Beirdo/obd-feather/README.md

# obd-feather
OBDII interface board with an attached Adafruit STM32F405 Feather Express.
