Beirdo/obd-feather/hardware/obd-feather/obd-feather.kicad_pcb

## KiCad design hardware/obd-feather/obd-feather.kicad_pcb (2023-03-13)

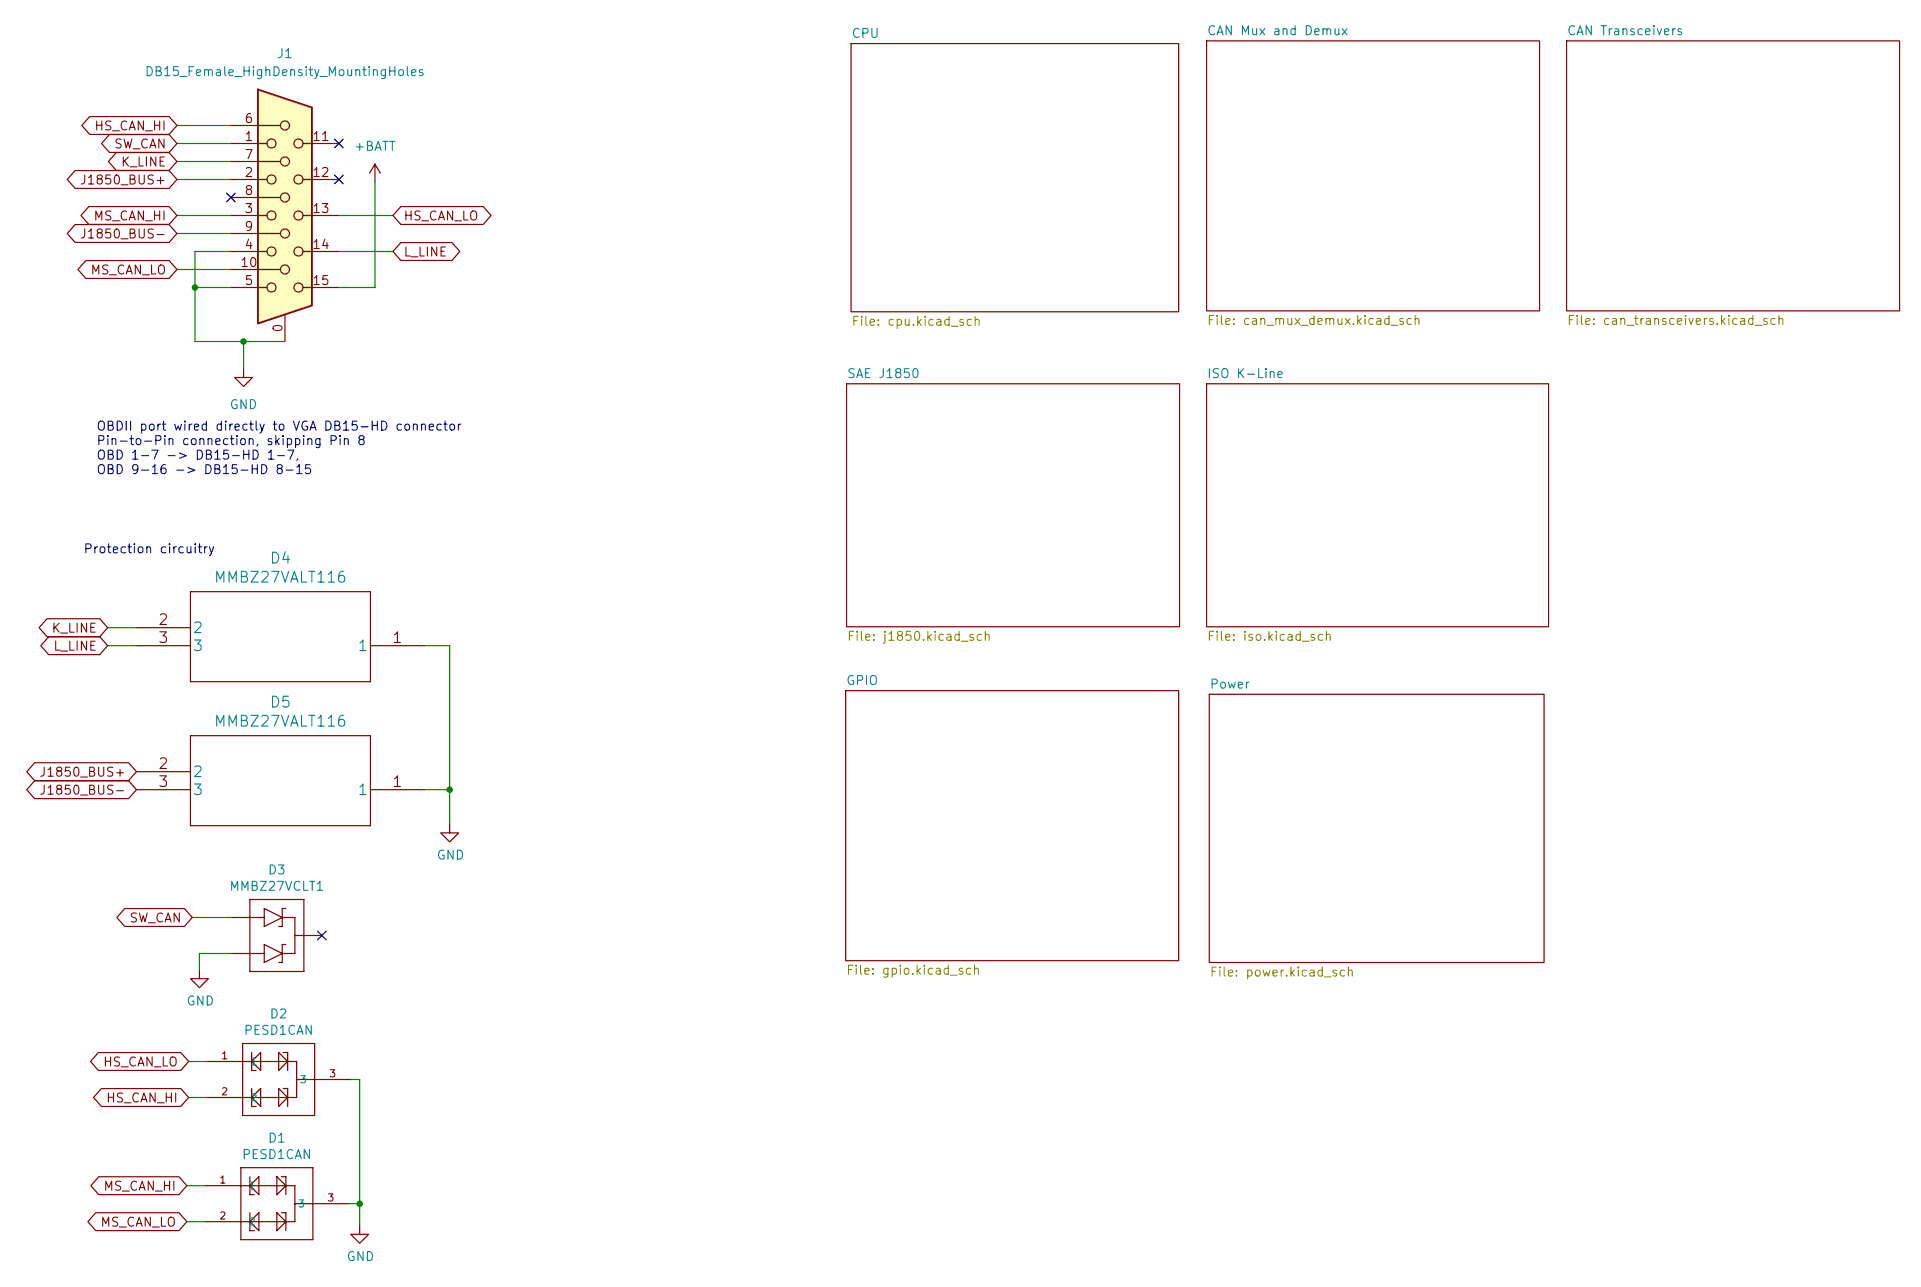
[picture p15: schematic obd-feather.kicad_sch, OBDII-Feather Interface]

Parts:
D1, D2: PESD1CAN; SOT23-3; Digikey 1727-3817-1-ND
D3: MMBZ27VCLT1; SOT23-3; Digikey MMBZ27VCL-FDICT-ND
D4, D5: MMBZ27VALT116; SOT23-3; Digikey MMBZ27VALT116CT-ND
J1: DB15_Female_HighDensity_MountingHoles; DSUB-15-HD_Female_Horizontal_P2.29x1.98mm_EdgePinOffset8.35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; Digikey L77HDE15SD1CH4FVGA-ND

Connections:
+BATT: J1.15; also elsewhere on the board
GND: D1.3, D2.3, D3.2 (A2), D4.1, D5.1, J1.0, J1.4, J1.5; also elsewhere on the board
HS_CAN_HI: D2.2, J1.6; also elsewhere on the board
HS_CAN_LO: D2.1, J1.13; also elsewhere on the board
J1850_BUS+: D5.2, J1.2; also elsewhere on the board
J1850_BUS-: D5.3, J1.9; also elsewhere on the board
K_LINE: D4.2, J1.7; also elsewhere on the board
L_LINE: D4.3, J1.14; also elsewhere on the board
MS_CAN_HI: D1.1, J1.3; also elsewhere on the board
MS_CAN_LO: D1.2, J1.10; also elsewhere on the board
SW_CAN: D3.1 (A1), J1.1; also elsewhere on the board

Notes on the sheet:
OBDII port wired directly to VGA DB15-HD connector Pin-to-Pin connection, skipping Pin 8 OBD 1-7 -> DB15-HD 1-7, OBD 9-16 -> DB15-HD 8-15
Protection circuitry

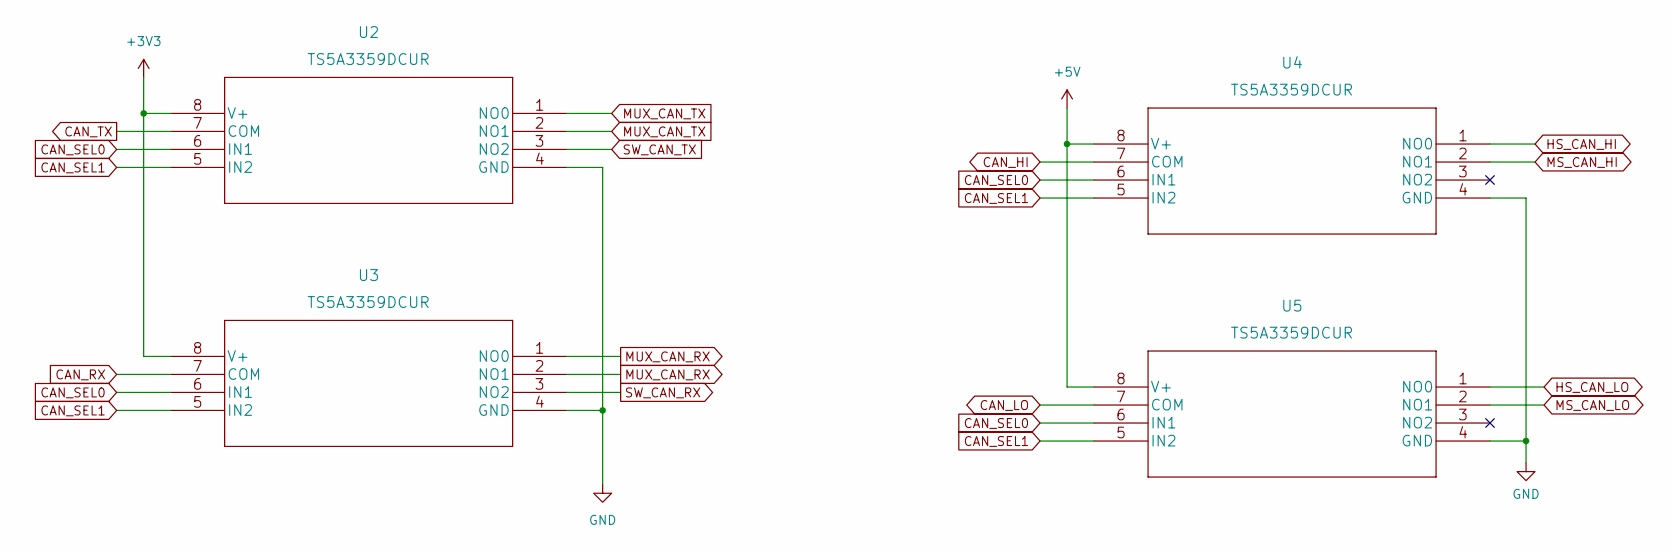
[picture p16: schematic can_mux_demux.kicad_sch, OBDII-Feather Interface]

Parts:
U2, U3, U4, U5: TS5A3359DCUR; Digikey 296-21193-1-ND

Connections:
+3V3: U2.8 (V+), U3.8 (V+); also elsewhere on the board
+5V: U4.8 (V+), U5.8 (V+); also elsewhere on the board
CAN_HI: U4.7 (COM); also elsewhere on the board
CAN_LO: U5.7 (COM); also elsewhere on the board
CAN_RX: U3.7 (COM); also elsewhere on the board
CAN_SEL0: U2.6 (IN1), U3.6 (IN1), U4.6 (IN1), U5.6 (IN1); also elsewhere on the board
CAN_SEL1: U2.5 (IN2), U3.5 (IN2), U4.5 (IN2), U5.5 (IN2); also elsewhere on the board
CAN_TX: U2.7 (COM); also elsewhere on the board
GND: U2.4 (GND), U3.4 (GND), U4.4 (GND), U5.4 (GND); also elsewhere on the board
HS_CAN_HI: U4.1 (NO0); also elsewhere on the board
HS_CAN_LO: U5.1 (NO0); also elsewhere on the board
MS_CAN_HI: U4.2 (NO1); also elsewhere on the board
MS_CAN_LO: U5.2 (NO1); also elsewhere on the board
MUX_CAN_RX: U3.1 (NO0), U3.2 (NO1); also elsewhere on the board
MUX_CAN_TX: U2.1 (NO0), U2.2 (NO1); also elsewhere on the board
SW_CAN_RX: U3.3 (NO2); also elsewhere on the board
SW_CAN_TX: U2.3 (NO2); also elsewhere on the board

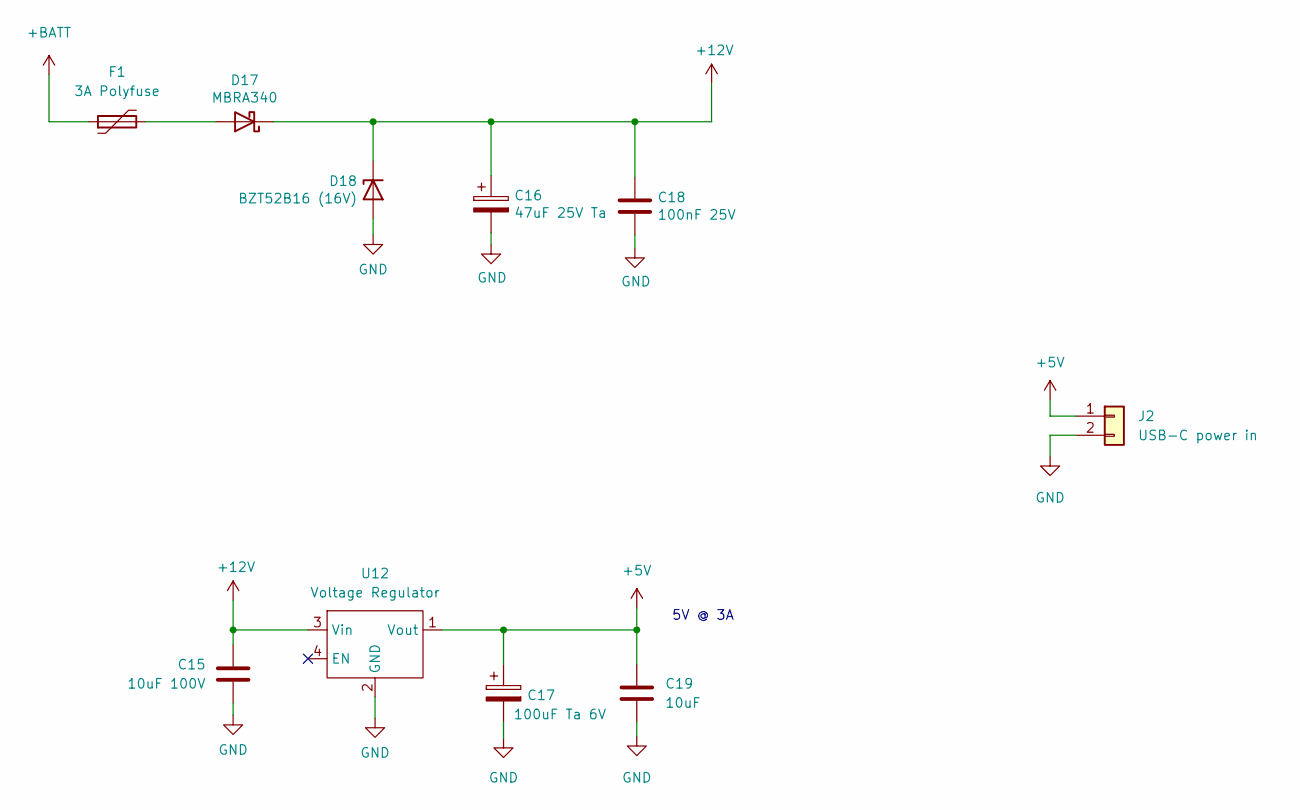
[picture p17: schematic power.kicad_sch, OBDII-Feather Interface]

Parts:
C15: 10uF 100V; C_1210_3225Metric_Pad1.33x2.70mm_HandSolder
C16: 47uF 25V Ta; CP_EIA-7343-31_Kemet-D_Pad2.25x2.55mm_HandSolder
C17: 100uF Ta 6V; CP_EIA-3216-10_Kemet-I_Pad1.58x1.35mm_HandSolder
C18: 100nF 25V; C_0805_2012Metric_Pad1.18x1.45mm_HandSolder
C19: 10uF; C_0805_2012Metric_Pad1.18x1.45mm_HandSolder
D17: MBRA340; D_SMA
D18: BZT52B16 (16V); D_SOD-123
F1: 3A Polyfuse; R_1812_4532Metric_Pad1.30x3.40mm_HandSolder; Digikey F2772CT-ND
J2: USB-C power in; PinHeader_1x02_P2.54mm_Vertical
U12: Voltage Regulator; Switching_Regulator_Module

Connections:
+5V: C17.1, C19.1, J2.1, U12.1 (Vout); also elsewhere on the board
+12V: C15.1, C16.1, C18.1, D17.1 (K), D18.1 (K), U12.3 (Vin); also elsewhere on the board
+BATT: F1.1; also elsewhere on the board
GND: C15.2, C16.2, C17.2, C18.2, C19.2, D18.2 (A), J2.2, U12.2 (GND); also elsewhere on the board
unnamed: D17.2 (A), F1.2

Notes on the sheet:
5V @ 3A

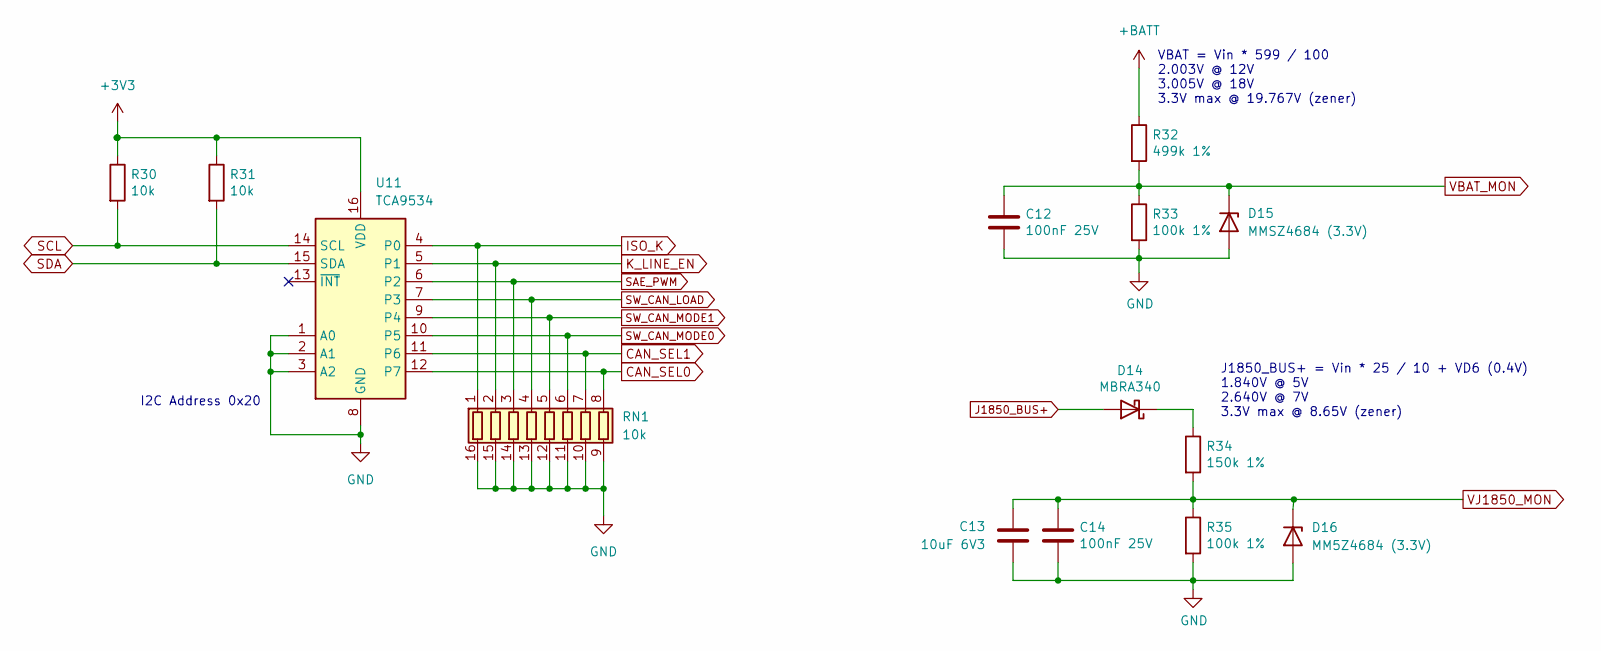
[picture p18: schematic gpio.kicad_sch, OBDII-Feather Interface]

Parts:
C12, C14: 100nF 25V; C_0805_2012Metric_Pad1.18x1.45mm_HandSolder
C13: 10uF 6V3; C_0805_2012Metric_Pad1.18x1.45mm_HandSolder
D14: MBRA340; D_SMA
D15: MMSZ4684 (3.3V); D_SOD-123
D16: MM5Z4684 (3.3V); D_SOD-123
R30, R31: 10k; R_0805_2012Metric_Pad1.20x1.40mm_HandSolder
R32: 499k 1%; R_0805_2012Metric_Pad1.20x1.40mm_HandSolder
R33, R35: 100k 1%; R_0805_2012Metric_Pad1.20x1.40mm_HandSolder
R34: 150k 1%; R_0805_2012Metric_Pad1.20x1.40mm_HandSolder
RN1: 10k; 742C163103JP
U11: TCA9534; TSSOP-16_4.4x5mm_P0.65mm

Connections:
+3V3: R30.1, R31.1, U11.16 (VDD); also elsewhere on the board
+BATT: R32.1; also elsewhere on the board
CAN_SEL0: RN1.8 (R8.1), U11.12 (P7); also elsewhere on the board
CAN_SEL1: RN1.7 (R7.1), U11.11 (P6); also elsewhere on the board
GND: C12.2, C13.1, C14.2, D15.2 (A), D16.2 (A), R33.2, R35.2, RN1.9 (R8.2), RN1.10 (R7.2), RN1.11 (R6.2), RN1.12 (R5.2), RN1.13 (R4.2), RN1.14 (R3.2), RN1.15 (R2.2), RN1.16 (R1.2), U11.1 (A0), U11.2 (A1), U11.3 (A2), U11.8 (GND); also elsewhere on the board
ISO_K: RN1.1 (R1.1), U11.4 (P0); also elsewhere on the board
J1850_BUS+: D14.2 (A); also elsewhere on the board
K_LINE_EN: RN1.2 (R2.1), U11.5 (P1); also elsewhere on the board
unnamed: D14.1 (K), R34.1
SAE_PWM: RN1.3 (R3.1), U11.6 (P2); also elsewhere on the board
SCL: R30.2, U11.14 (SCL); also elsewhere on the board
SDA: R31.2, U11.15 (SDA); also elsewhere on the board
SW_CAN_LOAD: RN1.4 (R4.1), U11.7 (P3); also elsewhere on the board
SW_CAN_MODE0: RN1.6 (R6.1), U11.10 (P5); also elsewhere on the board
SW_CAN_MODE1: RN1.5 (R5.1), U11.9 (P4); also elsewhere on the board
VBAT_MON: C12.1, D15.1 (K), R32.2, R33.1; also elsewhere on the board
VJ1850_MON: C13.2, C14.1, D16.1 (K), R34.2, R35.1; also elsewhere on the board

Notes on the sheet:
J1850_BUS+ = Vin * 25 / 10 + VD6 (0.4V) 1.840V @ 5V 2.640V @ 7V 3.3V max @ 8.65V (zener)
I2C Address 0x20
VBAT = Vin * 599 / 100 2.003V @ 12V 3.005V @ 18V 3.3V max @ 19.767V (zener)

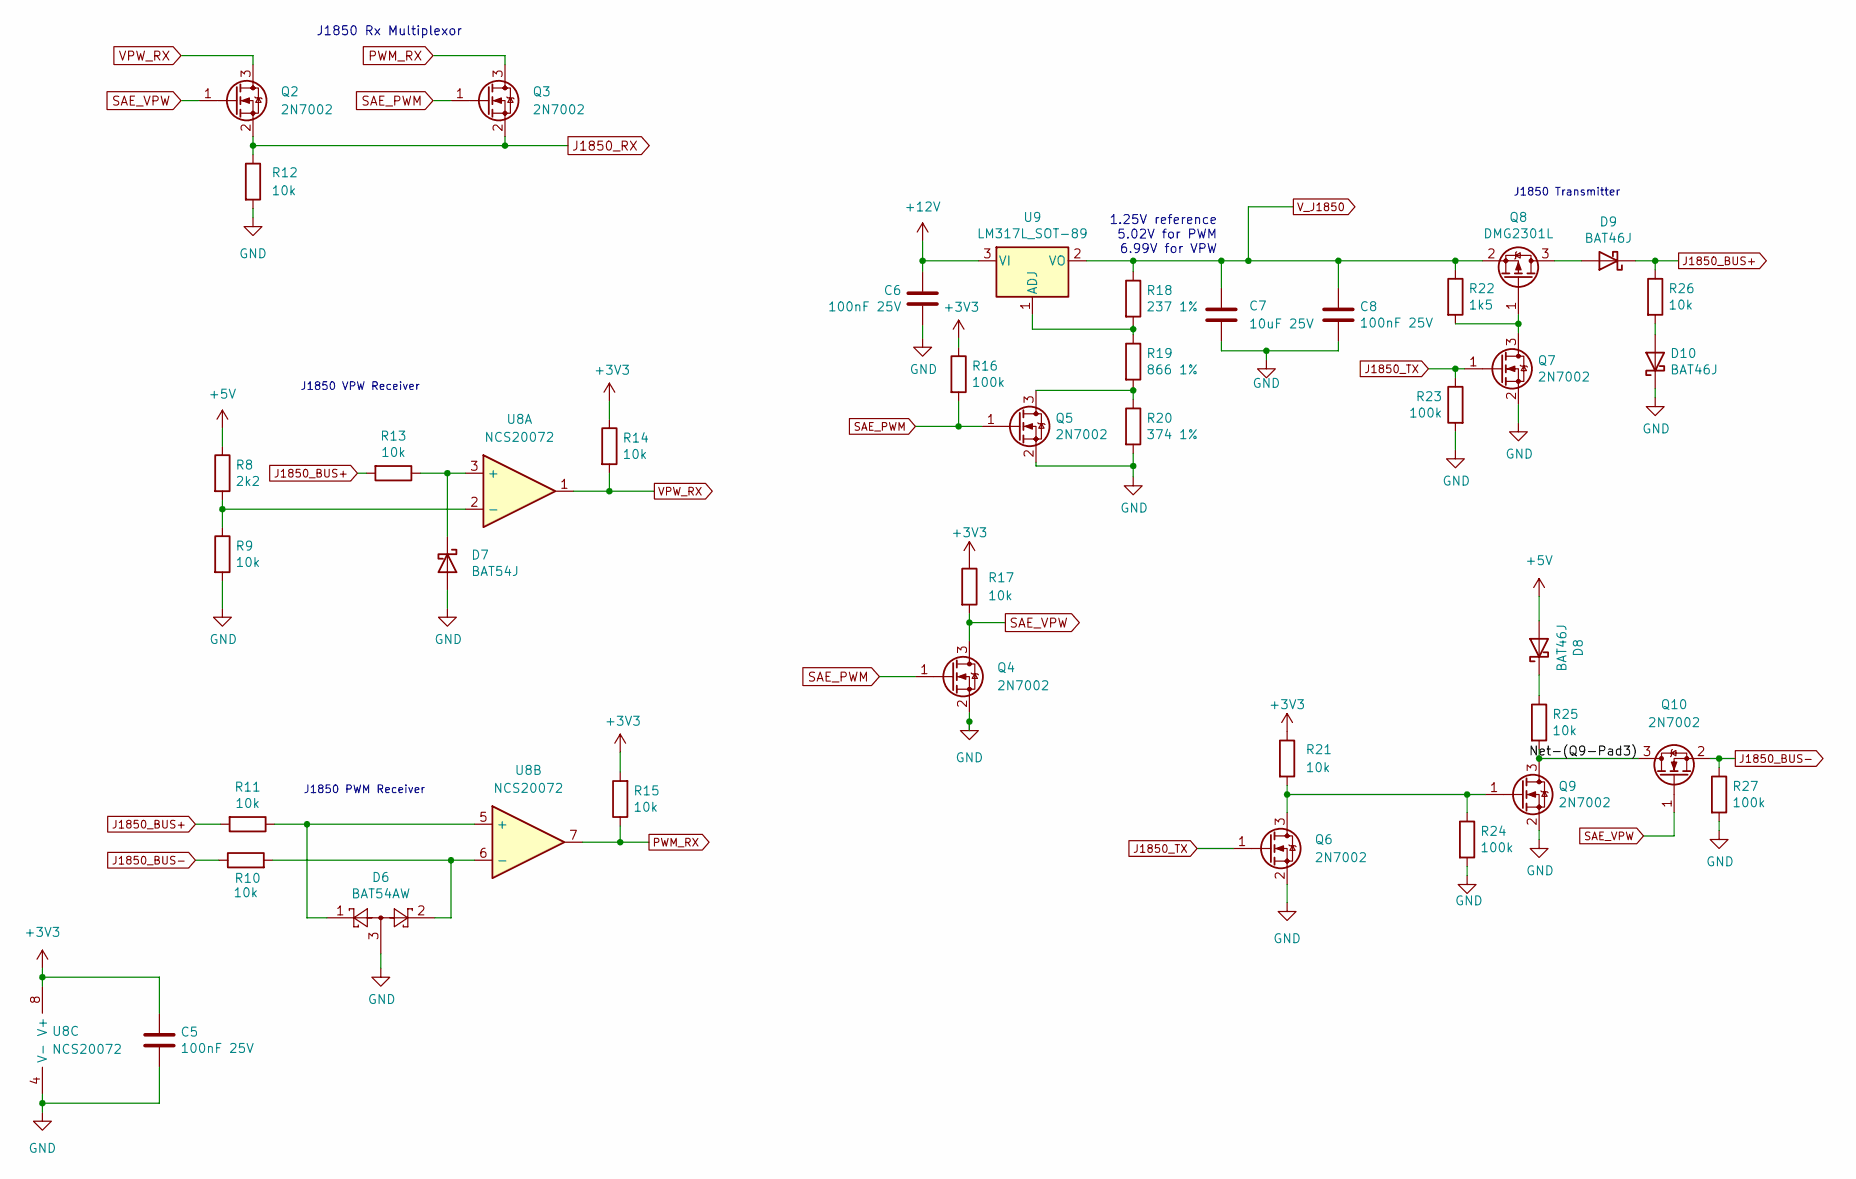
[picture p19: schematic j1850.kicad_sch, OBDII-Feather Interface]

Parts:
C5, C6, C8: 100nF 25V; C_0805_2012Metric_Pad1.18x1.45mm_HandSolder
C7: 10uF 25V; C_0805_2012Metric_Pad1.18x1.45mm_HandSolder
D6: BAT54AW; SOT-323_SC-70
D7: BAT54J; D_SOD-123
D8, D9, D10: BAT46J; D_SOD-123
Q2, Q3, Q4, Q5, Q6, Q7, Q9, Q10: 2N7002; SOT-23
Q8: DMG2301L; SOT-23
R8: 2k2; R_0805_2012Metric_Pad1.20x1.40mm_HandSolder
R9, R10, R11, R12, R13, R14, R15, R17, R21, R25, R26: 10k; R_0805_2012Metric_Pad1.20x1.40mm_HandSolder
R16, R23, R24, R27: 100k; R_0805_2012Metric_Pad1.20x1.40mm_HandSolder
R18: 237 1%; R_0805_2012Metric_Pad1.20x1.40mm_HandSolder
R19: 866 1%; R_0805_2012Metric_Pad1.20x1.40mm_HandSolder
R20: 374 1%; R_0805_2012Metric_Pad1.20x1.40mm_HandSolder
R22: 1k5; R_0805_2012Metric_Pad1.20x1.40mm_HandSolder
U8: NCS20072; TSSOP-8_4.4x3mm_P0.65mm
U9: LM317L_SOT-89; SOT-89-3

Connections:
+3V3: C5.2, R14.1, R15.2, R16.1, R17.1, R21.1, U8.8 (V+); also elsewhere on the board
+5V: D8.2 (A), R8.1; also elsewhere on the board
+12V: C6.2, U9.3 (VI); also elsewhere on the board
GND: C5.1, C6.1, C7.2, C8.2, D6.3, D7.2 (A), D10.1 (K), Q4.2 (S), Q5.2 (S), Q6.2 (S), Q7.2 (S), Q9.2 (S), R9.2, R12.2, R20.2, R23.2, R24.2, R27.2, U8.4 (V-); also elsewhere on the board
J1850_BUS+: D9.1 (K), R11.2, R13.2, R26.1; also elsewhere on the board
J1850_BUS-: Q10.2 (S), R10.1, R27.1; also elsewhere on the board
J1850_RX: Q2.2 (S), Q3.2 (S), R12.1; also elsewhere on the board
J1850_TX: Q6.1 (G), Q7.1 (G), R23.1; also elsewhere on the board
unnamed: D6.1, R11.1, U8.5 (+)
unnamed: D6.2, R10.2, U8.6 (-)
unnamed: D7.1 (K), R13.1, U8.3 (+)
unnamed: D8.1 (K), R25.1
unnamed: D9.2 (A), Q8.3 (D)
unnamed: D10.2 (A), R26.2
unnamed: Q5.3 (D), R19.2, R20.1
unnamed: Q6.3 (D), Q9.1 (G), R21.2, R24.1
unnamed: Q7.3 (D), Q8.1 (G), R22.2
unnamed: Q9.3 (D), Q10.3 (D), R25.2
unnamed: R8.2, R9.1, U8.2 (-)
unnamed: R18.2, R19.1, U9.1 (ADJ)
PWM_RX: Q3.3 (D), R15.1, U8.7
SAE_PWM: Q3.1 (G), Q4.1 (G), Q5.1 (G), R16.2; also elsewhere on the board
SAE_VPW: Q2.1 (G), Q4.3 (D), Q10.1 (G), R17.2
VPW_RX: Q2.3 (D), R14.2, U8.1
V_J1850: C7.1, C8.1, Q8.2 (S), R18.1, R22.1, U9.2 (VO)

Notes on the sheet:
J1850 Transmitter
J1850 Rx Multiplexor
J1850 VPW Receiver
J1850 PWM Receiver
1.25V reference 5.02V for PWM 6.99V for VPW

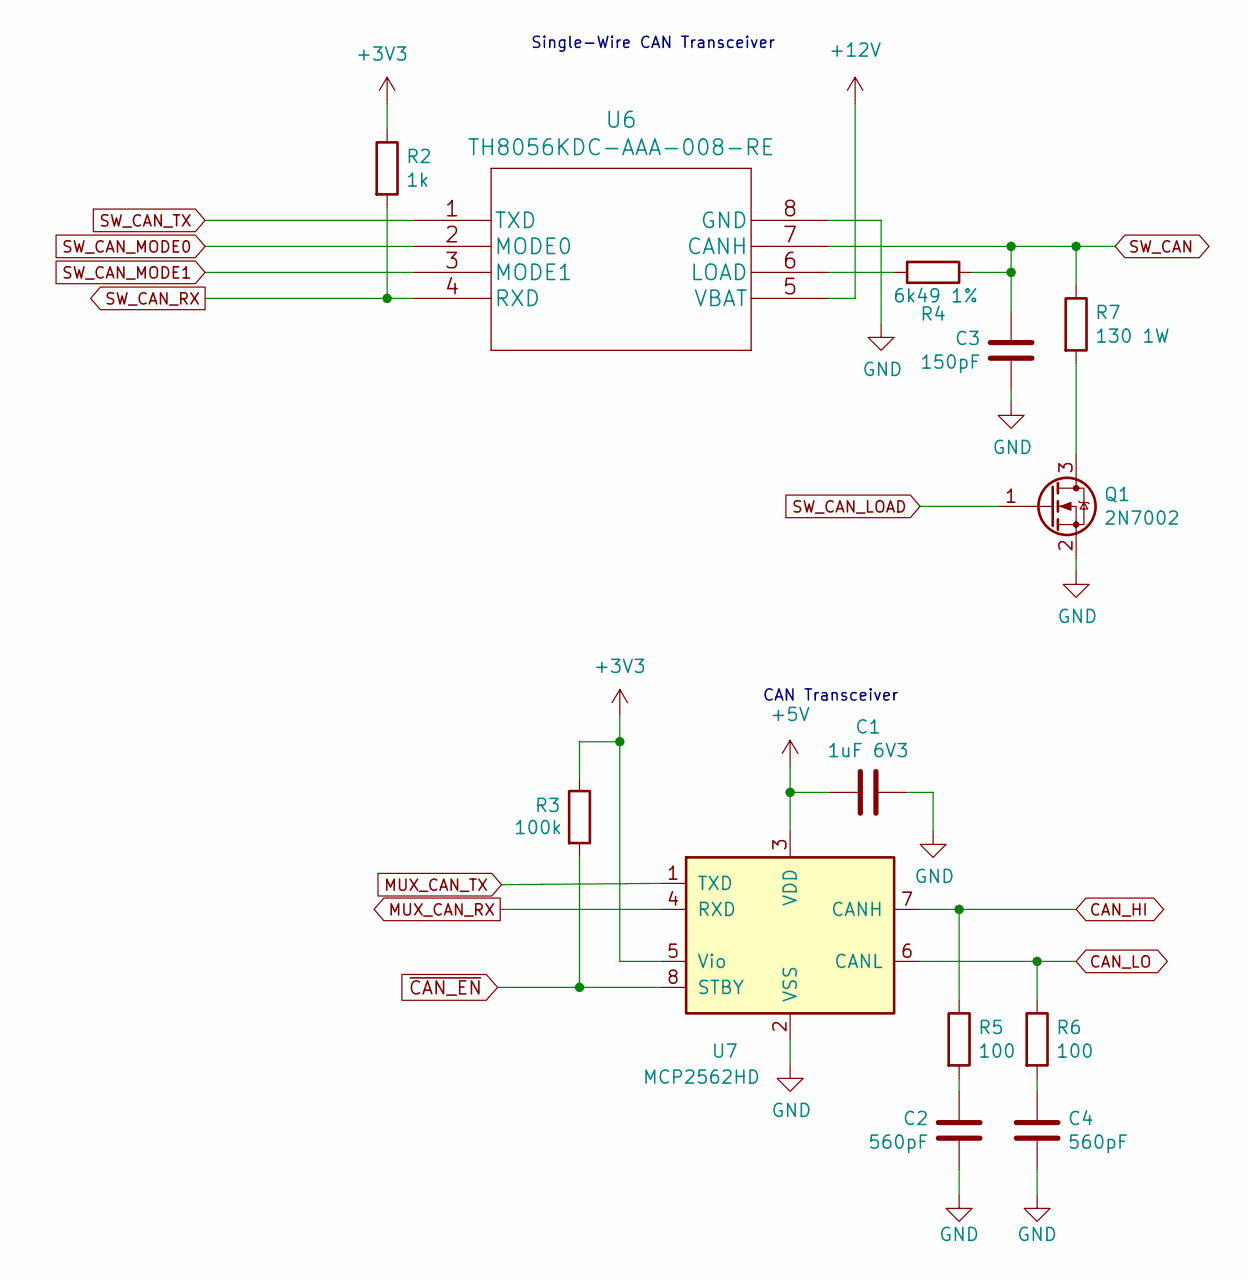
[picture p20: schematic can_transceivers.kicad_sch, OBDII-Feather Interface]

Parts:
C1: 1uF 6V3; C_0805_2012Metric_Pad1.18x1.45mm_HandSolder
C2, C4: 560pF; C_0805_2012Metric_Pad1.18x1.45mm_HandSolder
C3: 150pF; C_0805_2012Metric_Pad1.18x1.45mm_HandSolder
Q1: 2N7002; SOT-23
R2: 1k; R_0805_2012Metric_Pad1.20x1.40mm_HandSolder
R3: 100k; R_0805_2012Metric_Pad1.20x1.40mm_HandSolder
R4: 6k49 1%; R_0805_2012Metric_Pad1.20x1.40mm_HandSolder
R5, R6: 100; R_0805_2012Metric_Pad1.20x1.40mm_HandSolder
R7: 130 1W; R_2512_6332Metric_Pad1.40x3.35mm_HandSolder
U6: TH8056KDC-AAA-008-RE
U7: MCP2562HD; SOIC-8_3.9x4.9mm_P1.27mm

Connections:
+3V3: R2.1, R3.1, U7.5 (Vio); also elsewhere on the board
+5V: C1.2, U7.3 (VDD); also elsewhere on the board
+12V: U6.5 (VBAT); also elsewhere on the board
CAN_HI: R5.1, U7.7 (CANH); also elsewhere on the board
CAN_LO: R6.1, U7.6 (CANL); also elsewhere on the board
GND: C1.1, C2.1, C3.1, C4.2, Q1.2 (S), U6.8 (GND), U7.2 (VSS); also elsewhere on the board
MUX_CAN_RX: U7.4 (RXD); also elsewhere on the board
MUX_CAN_TX: U7.1 (TXD); also elsewhere on the board
unnamed: C2.2, R5.2
unnamed: C4.1, R6.2
unnamed: Q1.3 (D), R7.2
unnamed: R4.2, U6.6 (LOAD)
SW_CAN: C3.2, R4.1, R7.1, U6.7 (CANH); also elsewhere on the board
SW_CAN_LOAD: Q1.1 (G); also elsewhere on the board
SW_CAN_MODE0: U6.2 (MODE0); also elsewhere on the board
SW_CAN_MODE1: U6.3 (MODE1); also elsewhere on the board
SW_CAN_RX: R2.2, U6.4 (RXD); also elsewhere on the board
SW_CAN_TX: U6.1 (TXD); also elsewhere on the board
~CAN_EN: R3.2, U7.8 (STBY); also elsewhere on the board

Notes on the sheet:
CAN Transceiver
Single-Wire CAN Transceiver

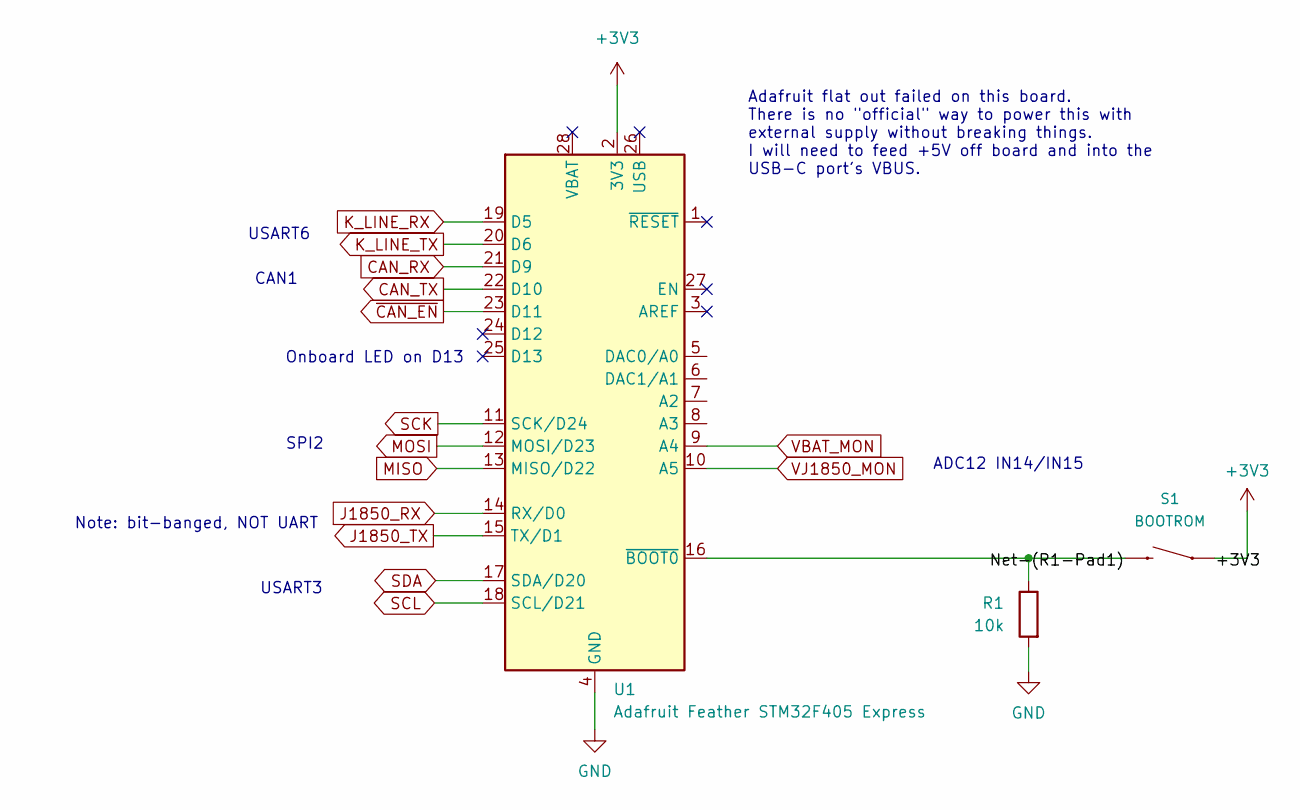
[picture p21: schematic cpu.kicad_sch, OBDII-Feather Interface]

Parts:
R1: 10k; R_0805_2012Metric_Pad1.20x1.40mm_HandSolder
S1: BOOTROM; TACTILE_SWITCH_PTH_6.0MM
U1: Adafruit Feather STM32F405 Express; Adafruit_Feather

Connections:
+3V3: S1.1, S1.2 (1), U1.2 (3V3); also elsewhere on the board
CAN_RX: U1.21 (D9); also elsewhere on the board
CAN_TX: U1.22 (D10); also elsewhere on the board
GND: R1.2, U1.4 (GND); also elsewhere on the board
J1850_RX: U1.14 (RX/D0); also elsewhere on the board
J1850_TX: U1.15 (TX/D1); also elsewhere on the board
K_LINE_RX: U1.19 (D5); also elsewhere on the board
K_LINE_TX: U1.20 (D6); also elsewhere on the board
MISO: U1.13 (MISO/D22)
MOSI: U1.12 (MOSI/D23)
SCK: U1.11 (SCK/D24)
SCL: U1.18 (SCL/D21); also elsewhere on the board
SDA: U1.17 (SDA/D20); also elsewhere on the board
VBAT_MON: U1.9 (A4); also elsewhere on the board
VJ1850_MON: U1.10 (A5); also elsewhere on the board
~CAN_EN: U1.23 (D11); also elsewhere on the board

Notes on the sheet:
Note: bit-banged, NOT UART
USART6
CAN1
Adafruit flat out failed on this board. There is no "official" way to power this with external supply without breaking things. I will need to feed +5V off board and into the USB-C port's VBUS.
USART3
SPI2
ADC12 IN14/IN15
Onboard LED on D13

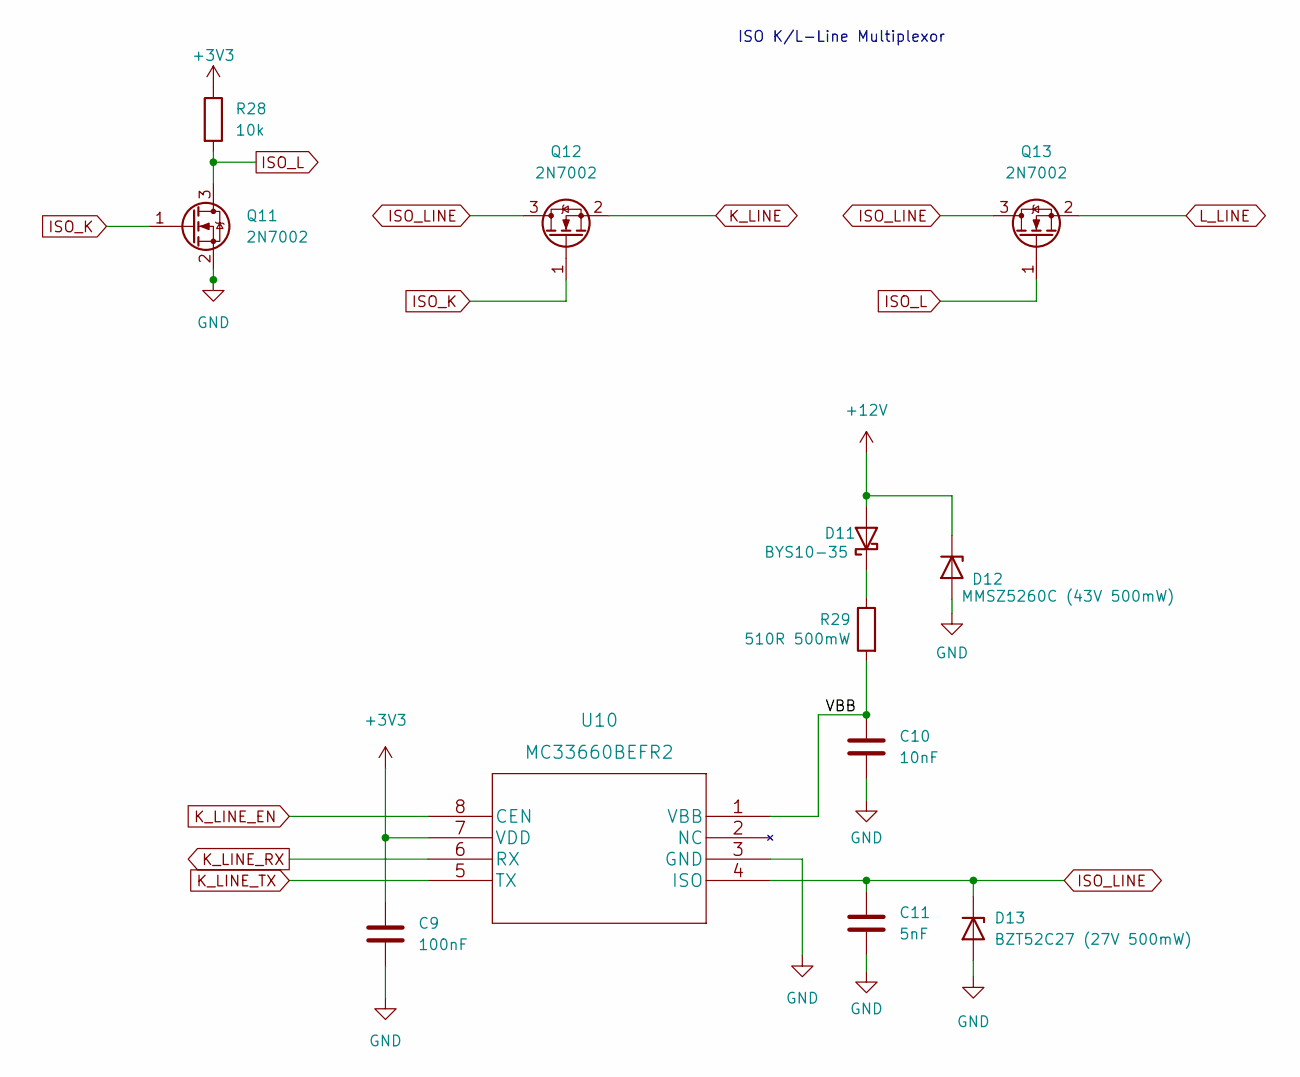
[picture p22: schematic iso.kicad_sch, OBDII-Feather Interface]

Parts:
C9: 100nF; C_0805_2012Metric_Pad1.18x1.45mm_HandSolder
C10: 10nF; C_0805_2012Metric_Pad1.18x1.45mm_HandSolder
C11: 5nF; C_0805_2012Metric_Pad1.18x1.45mm_HandSolder
D11: BYS10-35; D_SMA_Handsoldering
D12: MMSZ5260C (43V 500mW); D_SOD-123
D13: BZT52C27 (27V 500mW); D_SOD-123
Q11, Q12, Q13: 2N7002; SOT-23
R28: 10k; R_0805_2012Metric_Pad1.20x1.40mm_HandSolder
R29: 510R 500mW; R_1210_3225Metric_Pad1.30x2.65mm_HandSolder
U10: MC33660BEFR2

Connections:
+3V3: C9.1, R28.1, U10.7 (VDD); also elsewhere on the board
+12V: D11.2 (A), D12.1 (K); also elsewhere on the board
/ISO K-Line/VBB: C10.1, R29.2, U10.1 (VBB)
GND: C9.2, C10.2, C11.2, D12.2 (A), D13.2 (A), Q11.2 (S), U10.3 (GND); also elsewhere on the board
ISO_K: Q11.1 (G), Q12.1 (G); also elsewhere on the board
ISO_L: Q11.3 (D), Q13.1 (G), R28.2
ISO_LINE: C11.1, D13.1 (K), Q12.3 (D), Q13.3 (D), U10.4 (ISO)
K_LINE: Q12.2 (S); also elsewhere on the board
K_LINE_EN: U10.8 (CEN); also elsewhere on the board
K_LINE_RX: U10.6 (RX); also elsewhere on the board
K_LINE_TX: U10.5 (TX); also elsewhere on the board
L_LINE: Q13.2 (S); also elsewhere on the board
unnamed: D11.1 (K), R29.1

Notes on the sheet:
ISO K/L-Line Multiplexor

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
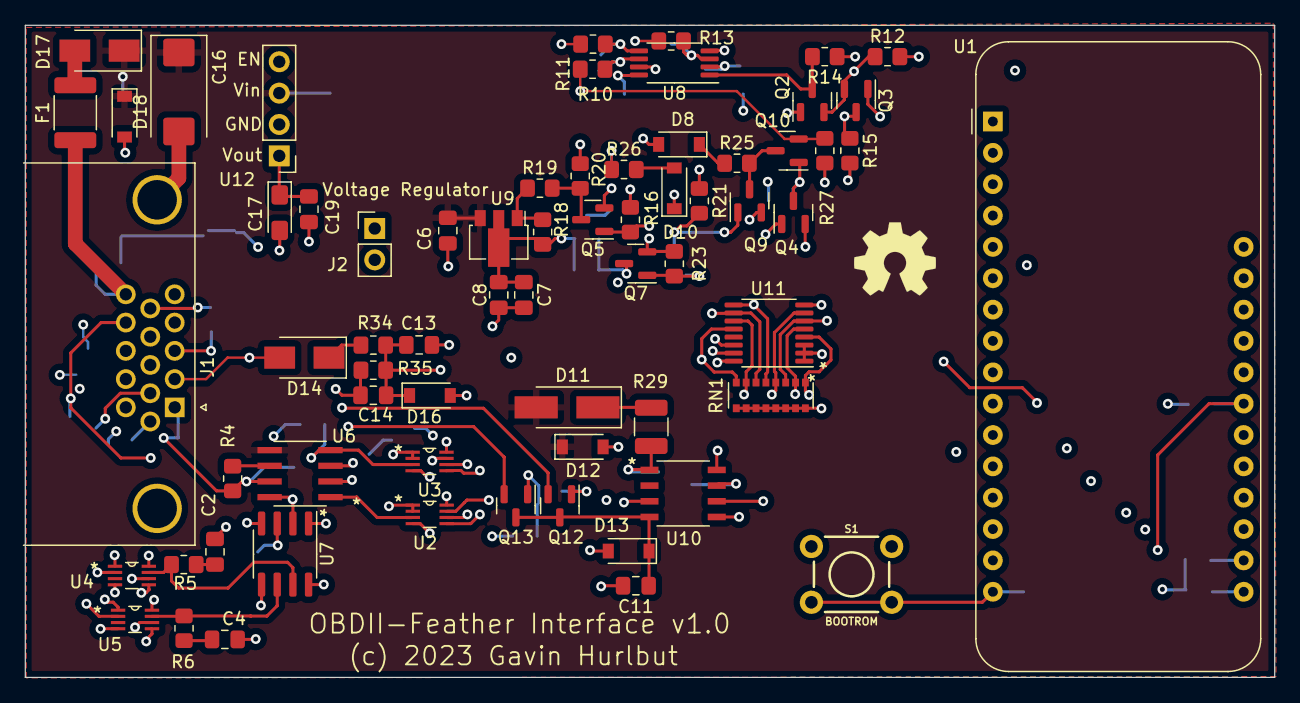
[picture p23: board obd-feather.kicad_pcb from above]

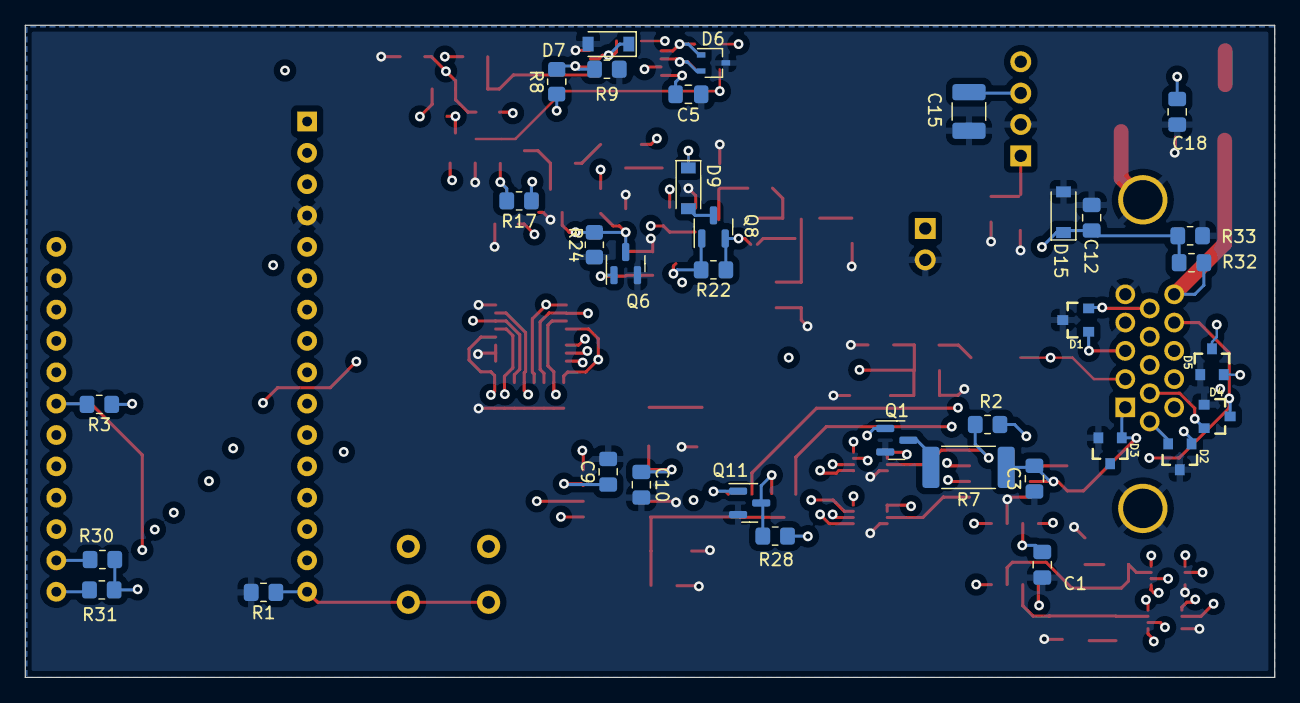
[picture p24: board obd-feather.kicad_pcb from below]

Board: 4 copper layers, 101.2 x 52.8 mm, 102 parts (35 on the bottom side), 66 nets.
