Beirdo/obd-feather/(commit log)

2023-01-03 Initial content commit
    [can_controller.kicad_sch, can_mux_demux.kicad_sch, can_transceivers.kicad_sch, gpio.kicad_sch, iso.kicad_sch, j1850.kicad_sch, power.kicad_sch, processor.kicad_sch]
2023-01-03 Added initial layout (parts dump)
    [can_controller.kicad_sch, can_mux_demux.kicad_sch, gpio.kicad_sch, iso.kicad_sch, j1850.kicad_sch, power.kicad_sch, qwiic-obd.kicad_pcb, qwiic-obd.kicad_sch]
2023-01-03 OK, layout v1 complete
    [can_controller.kicad_sch, can_mux_demux.kicad_sch, can_transceivers.kicad_sch, gpio.kicad_sch, iso.kicad_sch, j1850.kicad_sch, power.kicad_sch, qwiic-obd.kicad_pcb]
2023-01-03 Get it all connected (had a few unrouted glitches)
    [qwiic-obd.kicad_pcb]
2023-01-03 Fix a few tweaks
    [qwiic-obd.kicad_pcb]
2023-01-03 More silkscreen fun
    [qwiic-obd.kicad_pcb]
2023-01-03 And broke the ground plane again... fixed.
    [qwiic-obd.kicad_pcb]
2023-01-03 Like I remember
    [qwiic-obd.kicad_pcb]
2023-01-03 Fix title block
    [can_controller.kicad_sch, can_mux_demux.kicad_sch, can_transceivers.kicad_sch, gpio.kicad_sch, iso.kicad_sch, j1850.kicad_sch, power.kicad_sch, qwiic-obd.kicad_sch]
2023-01-03 Fix a couple dumb bugs
    [i2c_slave.c, ringbuf.c]
2023-01-04 Add PIC bootloader, update silkscreen
    [gpio.kicad_sch, j1850.kicad_sch, qwiic-obd.kicad_pcb, qwiic-obd.kicad_sch]
2023-01-04 Split firmware into two separate projects
    - got it building into different parts of the FLASH.
    - bootloader - 0x000 - 0x3FF (word addresses)
    - application - 0x400 - end (word addresses)
    - reset vector and interrupt vector are also mirrored
    into 0x400 and 0x404 (respectively) for application
    use, and are linked to from the bootloader
    - when the BL_ENABLE button is pushed while in the
    application, a falling edge interrupt causes a reset
    back into the bootloader.
    [gpio.kicad_sch, j1850.kicad_sch, qwiic-obd.kicad_sch]
2023-01-05 Added BL_LED on PA0, with a jumper
    - if using ICSP, move jumper to 2,3 and PA0 is ISCPDAT
    - if using bootloader, move jumper to 1,2 and PA0 is the LED
    [j1850.kicad_sch, qwiic-obd.kicad_pcb, qwiic-obd.kicad_sch]
2023-01-05 Added gerbers
    [qwiic-obd-B_Cu.gbr, qwiic-obd-B_Mask.gbr, qwiic-obd-B_Paste.gbr, qwiic-obd-B_Silkscreen.gbr, qwiic-obd-Edge_Cuts.gbr, qwiic-obd-F_Cu.gbr, qwiic-obd-F_Mask.gbr, qwiic-obd-F_Paste.gbr]
2023-01-06 Changed DB15HD connector, fixed layout
    [qwiic-obd-B_Cu.gbr, qwiic-obd-B_Mask.gbr, qwiic-obd-B_Paste.gbr, qwiic-obd-B_Silkscreen.gbr, qwiic-obd-Edge_Cuts.gbr, qwiic-obd-F_Cu.gbr, qwiic-obd-F_Mask.gbr, qwiic-obd-F_Paste.gbr]
2023-01-09 Shrunk layout a bit
    [can_controller.kicad_sch, can_mux_demux.kicad_sch, gpio.kicad_sch, iso.kicad_sch, j1850.kicad_sch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]
2023-01-10 Fill out shield definition
    - here's hoping I did this right. Until I have application code to
    compile (and drivers), I won't know.
2023-01-10 First run at a driver for the MCP342x ADC series
2023-01-10 Add first run at SC18IS602B driver, add some data sheets
2023-01-10 Added SC16IS741A UART and added datasheet
2023-01-27 Moved to using shared KiCad libs, regen gerbers
    [qwiic-obd-B_Cu.gbr, qwiic-obd-B_Mask.gbr, qwiic-obd-B_Paste.gbr, qwiic-obd-B_Silkscreen.gbr, qwiic-obd-Edge_Cuts.gbr, qwiic-obd-F_Cu.gbr, qwiic-obd-F_Mask.gbr, qwiic-obd-F_Paste.gbr]
2023-02-08 Switch out the PIC for an ATtiny424.
    [can_controller.kicad_sch, can_mux_demux.kicad_sch, can_transceivers.kicad_sch, gpio.kicad_sch, iso.kicad_sch, j1850.kicad_sch, power.kicad_sch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]
2023-02-08 Time to redo the firmware in Arduino
2023-02-08 Looks like we need direct port access
    - pulseIn needs the pulse to be isolated (LOW-HIGH-LOW)
    - we need to find the next edge... so interrupt handler on both edges.
2023-02-25 Moved git libs to new repo
    - https://github.com/Beirdo/KiCad-Git-Libraries
    [can_mux_demux.kicad_sch, qwiic-obd.kicad_sch]
2023-03-10 Started moving the qwiic-obd firmware over to PlatformIO
    - targeting the Adafruit F405 Express Feather board, running zephyr
2023-03-13 Redid the entire design to be a large feather-wing
    [can_controller.kicad_sch, can_mux_demux.kicad_sch, can_transceivers.kicad_sch, cpu.kicad_sch, gpio.kicad_sch, iso.kicad_sch, j1850.kicad_sch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]
2023-03-13 Update schematic PDF
2023-03-13 Forgot to save...
    [can_mux_demux.kicad_sch, can_transceivers.kicad_sch, cpu.kicad_sch, gpio.kicad_sch, iso.kicad_sch, j1850.kicad_sch, obd-feather.kicad_sch, power.kicad_sch]
2023-03-13 Rename the board in PlatformIO
2023-03-13 Add in the sample CAN application as a starting place
2023-03-13 Adding more drivers, labelling the external GPIO
2023-03-13 Seems I might need to write a driver for TCA9534
    - or extend the PCA953x, which currently supports only TCA9538
2023-03-13 Got it compiling with SSD1306 support, and ADC enabled
2023-03-14 Add support for mode switching and scanning
    - scanning incomplete as it will just assume that it's getting traffic
    as there is no mechanism in yet to indicate traffic flow
2023-03-14 Start the C++ implementation
    - still stuck on how I want to do the receive path for the moment
    [canbus.cpp, canbus.h, gpio_map.h, modes.h, obd2.cpp, obd2.h]
2023-03-14 Ooops, PID number is actually only one byte
    - need to refactor into an OBDII buffer
2023-03-20 Added in KLine support (ISO9141 and ISO-14230/KWP)
    [cpu.kicad_sch]
2023-03-21 Add support to mount an SD card at /SD
    - will need to deal with the eventuality of no card detected.
